tzpranto/Flood-Gate-Controller/README.md

# Automatic Flood Gate Controller Using Atmega32

## CSE316: Microprocessors and Microcontrollers Sessional

Project Description: [https://www.overleaf.com/read/gwkkzdkfvqtr](https://www.overleaf.com/read/gwkkzdkfvqtr)

# Click the thumbnail below to watch the project video
IMAGE ALT TEXT (http://www.youtube.com/watch?v=x_BLtaaKwBU "Flood Gate Controller")
