tzpranto/Flood-Gate-Controller/Presentation/Project-Proposal.pptx

## Automated Floodgate control and Flood Detection

Student ID :
1405013
1405015

## Brief Project Description :

- Detection of water level using water level sensors
- Controlling floodgate depending on water level
- Use of alarm when water level reaches danger point
- Calculating increase or decrease rate of water level
- Use of GPS to make a central detection system for issuing warning

## Input of our system

- Water Level
- Longitude and latitude from GPS

## Output of our system

- Display water level on LCD monitor
- Trigger alarm if water level reaches danger point
- GPS locations

## List of sensors

- Liquid Level /Pressure / Sonar (Sensor)
- GPS

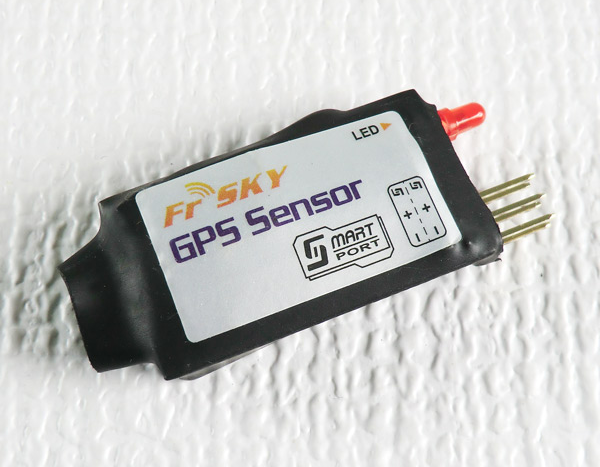
[picture p1: figure]
A picture containing object Description generated with high confidence
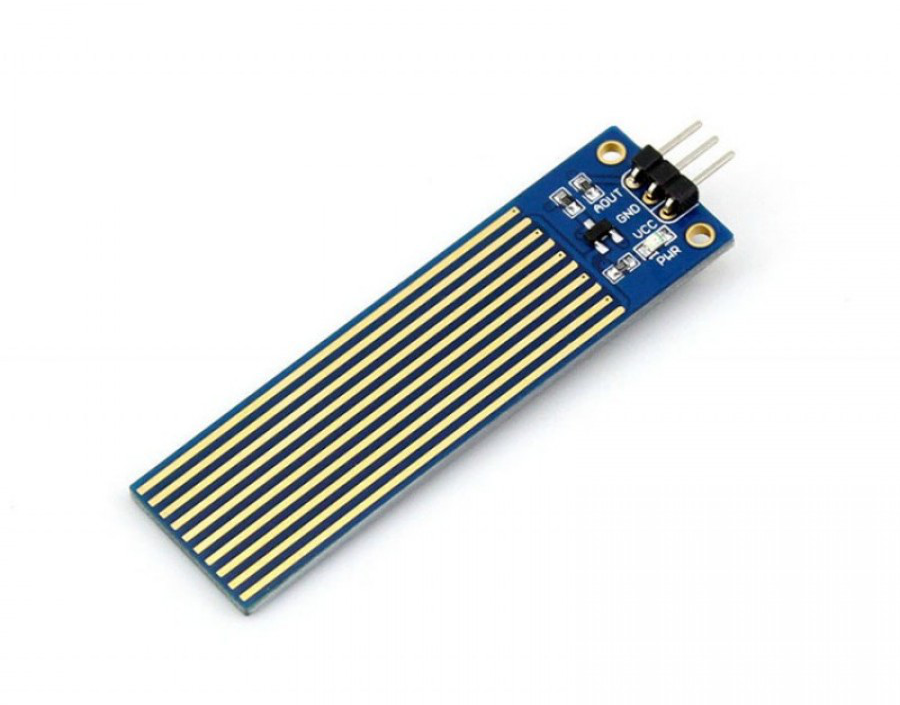
[picture p2: figure]
A circuit board Description generated with high confidence

## List of Actuators

- Floodgate (Electric)

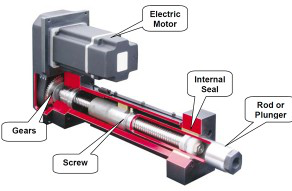
[picture p3: figure]
A close up of a device Description generated with very high confidence

## Outcome of our project

- Low cost flood detection system
- Automated floodgate control
- GPS can be used to develop a central system which will allow efficient dam management.

## Slide 8

Thank You
