tzpranto/Flood-Gate-Controller/Diagrams/FloodGateSimulation.png

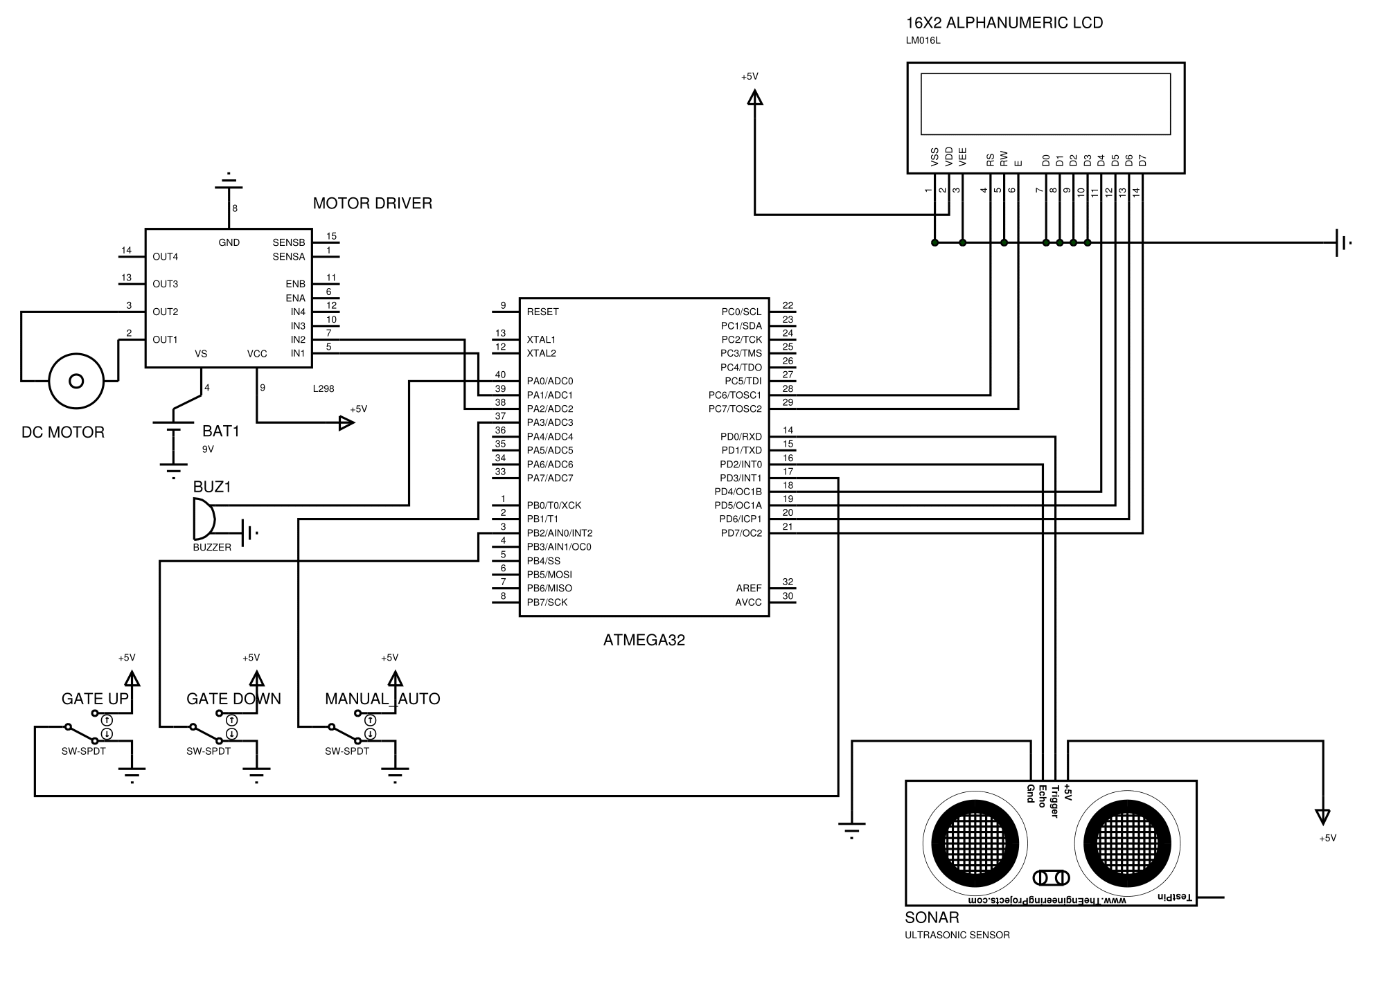
Diagrams/FloodGateSimulation.png
