tzpranto/Flood-Gate-Controller/Diagrams/FloodGateSimulation.PDF

## 16X2 ALPHANUMERIC LCD

## MOTOR DRIVER

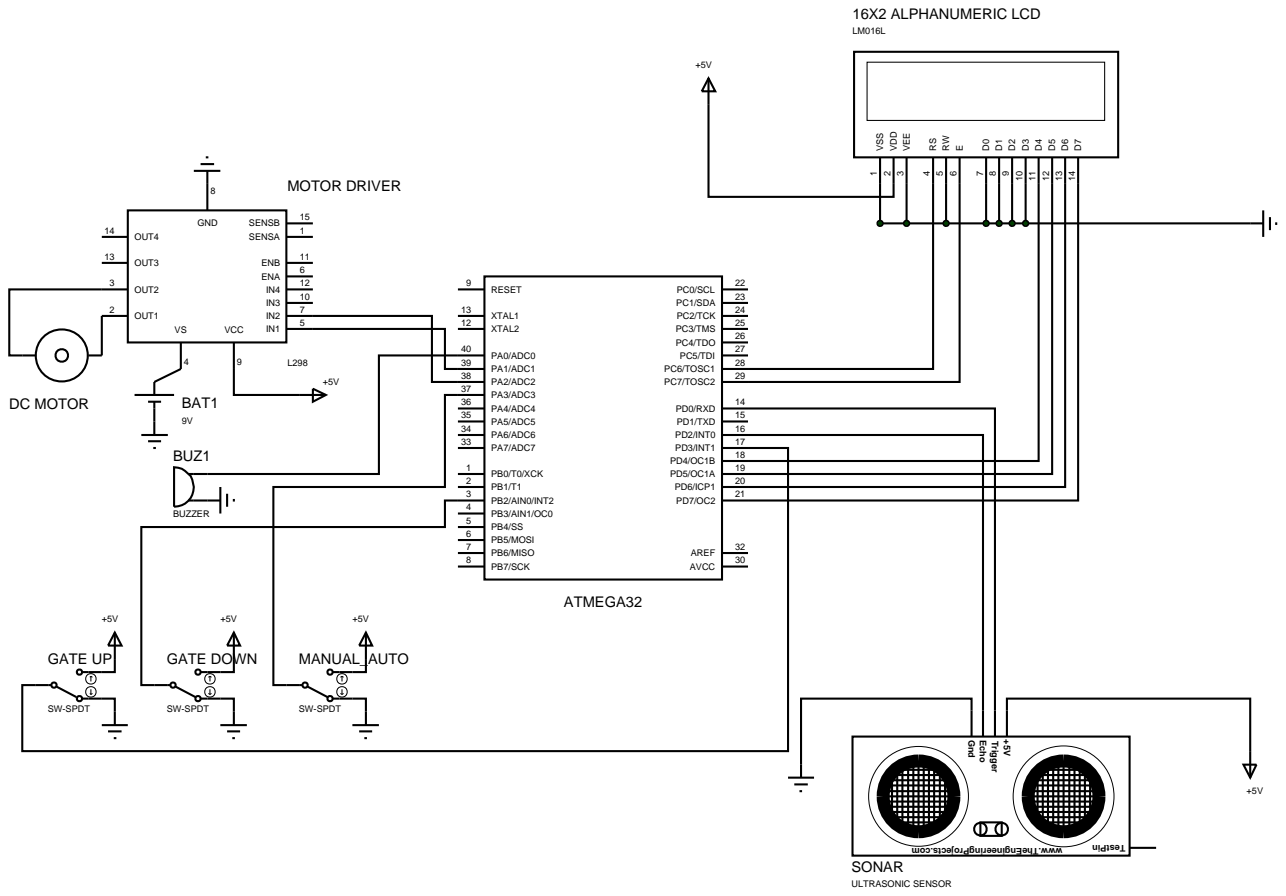
[picture p16: page 1]
