tzpranto/Flood-Gate-Controller/(list of files, drawings)

Other design files:
Diagrams/FloodGateSimulation.pdsprj
