tzpranto/Flood-Gate-Controller/(commit log)

2018-01-06 Commit 2
    [FloodGateSimulation.pdsprj]
2018-01-11 push button gate controller code
2018-01-11 simulation modified
    [FloodGateSimulation.pdsprj]
2018-01-17 Block Diagram
    [FloodGateSimulation.pdsprj]
